dacut/hdmi-breakout/Out of stock.xlsx

JLCPCB Part # | Manufacturer | Manufacturer Part # | Description | Replacement | Replacement JLCPCB Part # | Replacement Manufacturer | Replacement Manufacturer Part # | Quote Ok?
C1856484 | Yageo | CC0402MRX6S5BB106 | 10uF 20% 0402 Cap | 10uF 20% 0805 Cap | C346216 | Samsung Electro-Mechanics | CL21A106MOFNNNE | N
C4231501 | KOA Speer Electric | SG73P1EWTTP2212F | 22.1k 1% 0402 Res | 22.1k 1% 0402 Res | C2130243 | Vishay Intertech | TNPW040222K1FEED | N
C4112064 | KOA Speer Electric | SG73P1EWTTP331G | 330 1% 0402 Res | 330 1% 0402 Res | C2131941 | Vishay Intertech | TNPW0402330RDEED | N
C4319604 | KOA Speer Electric | SG73P1EWTTP5101F | 5.1k 1% 0402 Res | 5.1k 1% 0402 Res | C2131849 | Vishay Intertech | TNPW04025K10DEED | ?
C4351795 | KOA Speer Electric | SG73P1EWTTP4751F | 4.75k 1% 0402 Res | 4.75k 1% 0402 Res | C4096848 | Vishay Intertech | TNPW04024K75DEED | N
C2500653 | KOA Speer Electric | RN73R1ETTP7061F25 | 7.06k 1% 0402 Res | 7.06k 1% 0402 Res | C4345381 | Vishay Intertech | TNPW04027K06DEED | N
C346216 | Samsung Electro-Mechanics | CL21A106MOFNNNE | 10uF 20% 0402 Cap | 10uF 20% 0805 Cap | C5189822 | Samwha Capacitor | CS2012X7R106M100NRE
C2130243 | Vishay Intertech | TNPW040222K1FEED | 22.1k 1% 0402 Res | 22.1k 1% 0402 Res | C43473 | Uni-Royal | 0402WGF2212TCE
C2131941 | Vishay Intertech | TNPW0402330RDEED | 330 1% 0402 Res | 330 1% 0402 Res | C427206 | Panasonic | ERJPA2J331X
C4096848 | Vishay Intertech | TNPW04024K75DEED | 4.75k 1% 0402 Res | 4.75k 1% 0402 Res | C25901 | Uni-Royal | 0402WGF4751TCE
~~C4345381~~ | ~~Vishay Intertech~~ | ~~TNPW04027K06DEED~~ | ~~7.06k 1% 0402 Res~~ | ~~7.06k 1% 0402 Res~~
