dacut/hdmi-breakout/HDMI Breakout.kicad_pcb

## KiCad design HDMI Breakout.kicad_pcb (2024-10-12)

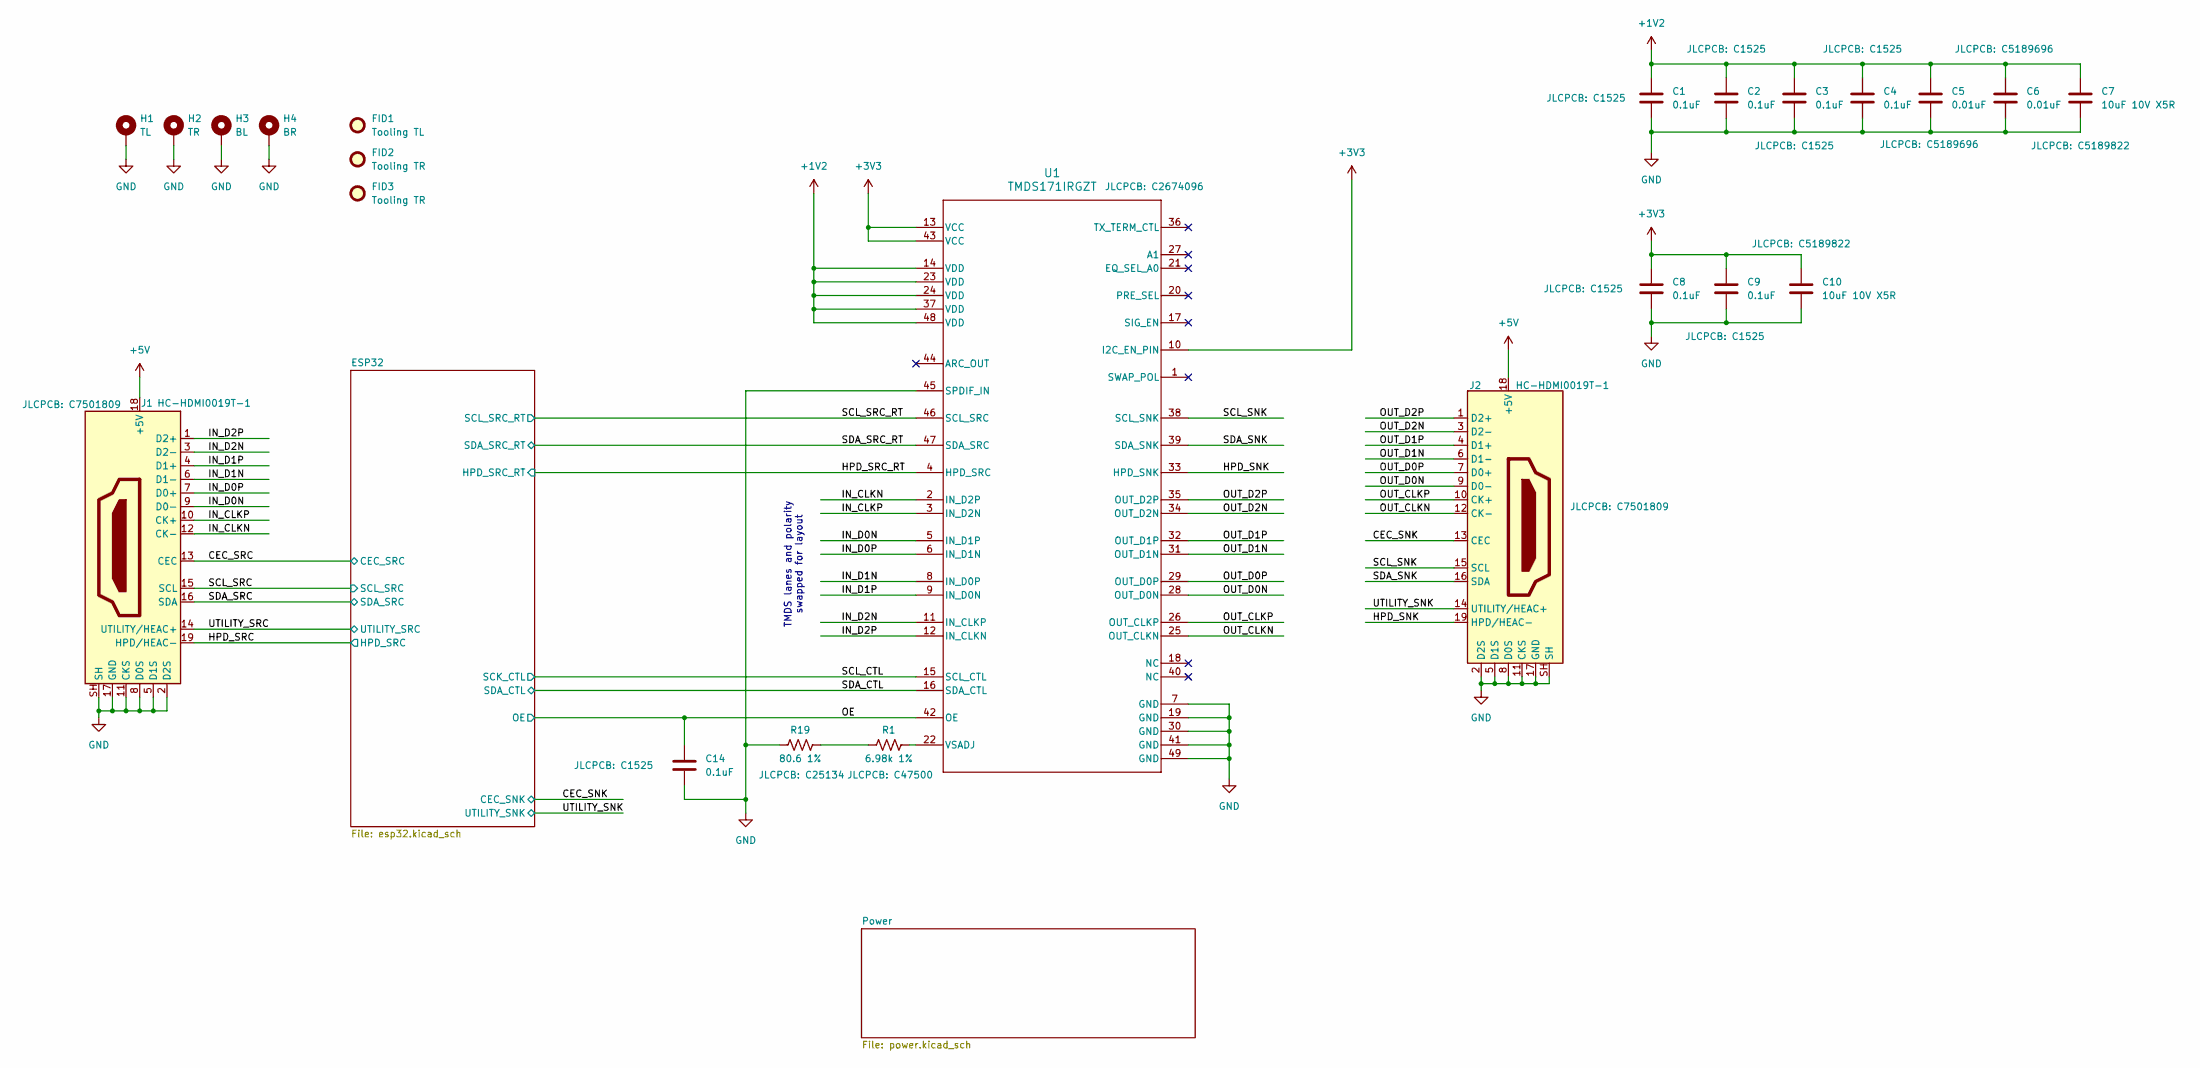
[picture p1: schematic HDMI Breakout.kicad_sch]

Parts:
C1, C2, C3, C4, C8, C9, C14: 0.1uF; C_0402_1005Metric; JLCPCB C1525
C5, C6: 0.01uF; C_0402_1005Metric; JLCPCB C5189696
C7, C10: 10uF 10V X5R; C_0805_2012Metric; JLCPCB C5189822
FID1: Tooling TL; Fiducial_JLCPCB
FID2, FID3: Tooling TR; Fiducial_JLCPCB
H1: TL; MountingHole_2.2mm_M2_Pad
H2: TR; MountingHole_2.2mm_M2_Pad
H3: BL; MountingHole_2.2mm_M2_Pad
H4: BR; MountingHole_2.2mm_M2_Pad
J1, J2: HC-HDMI0019T-1; JLCPCB C7501809
R1: 6.98k 1%; R_0402_1005Metric; JLCPCB C47500
R19: 80.6 1%; R_0402_1005Metric; JLCPCB C25134
U1: TMDS171IRGZT; RGZ0048B_NV; JLCPCB C2674096

Connections:
+1V2: C1.1, C2.1, C3.1, C4.1, C5.1, C6.1, C7.1, U1.14 (VDD), U1.23 (VDD), U1.24 (VDD), U1.37 (VDD), U1.48 (VDD); also elsewhere on the board
+3V3: C8.1, C9.1, C10.1, U1.10 (I2C_EN_PIN), U1.13 (VCC), U1.43 (VCC); also elsewhere on the board
+5V: J1.18 (+5V), J2.18 (+5V); also elsewhere on the board
/CEC_SNK: J2.13 (CEC); also elsewhere on the board
/CEC_SRC: J1.13 (CEC); also elsewhere on the board
/HPD_SNK: J2.19 (HPD/HEAC-), U1.33 (HPD_SNK)
/HPD_SRC: J1.19 (HPD/HEAC-); also elsewhere on the board
/HPD_SRC_RT: U1.4 (HPD_SRC); also elsewhere on the board
/IN_CLKN: J1.12 (CK-), U1.2 (IN_D2P)
/IN_CLKP: J1.10 (CK+), U1.3 (IN_D2N)
/IN_D0N: J1.9 (D0-), U1.5 (IN_D1P)
/IN_D0P: J1.7 (D0+), U1.6 (IN_D1N)
/IN_D1N: J1.6 (D1-), U1.8 (IN_D0P)
/IN_D1P: J1.4 (D1+), U1.9 (IN_D0N)
/IN_D2N: J1.3 (D2-), U1.11 (IN_CLKP)
/IN_D2P: J1.1 (D2+), U1.12 (IN_CLKN)
/OE: C14.1, U1.42 (OE); also elsewhere on the board
/OUT_CLKN: J2.12 (CK-), U1.25 (OUT_CLKN)
/OUT_CLKP: J2.10 (CK+), U1.26 (OUT_CLKP)
/OUT_D0N: J2.9 (D0-), U1.28 (OUT_D0N)
/OUT_D0P: J2.7 (D0+), U1.29 (OUT_D0P)
/OUT_D1N: J2.6 (D1-), U1.31 (OUT_D1N)
/OUT_D1P: J2.4 (D1+), U1.32 (OUT_D1P)
/OUT_D2N: J2.3 (D2-), U1.34 (OUT_D2N)
/OUT_D2P: J2.1 (D2+), U1.35 (OUT_D2P)
/SCL_CTL: U1.15 (SCL_CTL); also elsewhere on the board
/SCL_SNK: J2.15 (SCL), U1.38 (SCL_SNK)
/SCL_SRC: J1.15 (SCL); also elsewhere on the board
/SCL_SRC_RT: U1.46 (SCL_SRC); also elsewhere on the board
/SDA_CTL: U1.16 (SDA_CTL); also elsewhere on the board
/SDA_SNK: J2.16 (SDA), U1.39 (SDA_SNK)
/SDA_SRC: J1.16 (SDA); also elsewhere on the board
/SDA_SRC_RT: U1.47 (SDA_SRC); also elsewhere on the board
/UTILITY_SNK: J2.14 (UTILITY/HEAC+); also elsewhere on the board
/UTILITY_SRC: J1.14 (UTILITY/HEAC+); also elsewhere on the board
GND: C1.2, C2.2, C3.2, C4.2, C5.2, C6.2, C7.2, C8.2, C9.2, C10.2, C14.2, H1.1, H2.1, H3.1, H4.1, J1.2 (D2S), J1.5 (D1S), J1.8 (D0S), J1.11 (CKS), J1.17 (GND), J1.SH, J2.2 (D2S), J2.5 (D1S), J2.8 (D0S), J2.11 (CKS), J2.17 (GND), J2.SH, R19.1, U1.7 (GND), U1.19 (GND), U1.30 (GND), U1.41 (GND), U1.45 (SPDIF_IN), U1.49 (GND); also elsewhere on the board
unnamed: R1.1, R19.2
unnamed: R1.2, U1.22 (VSADJ)

Notes on the sheet:
TMDS lanes and polarity swapped for layout

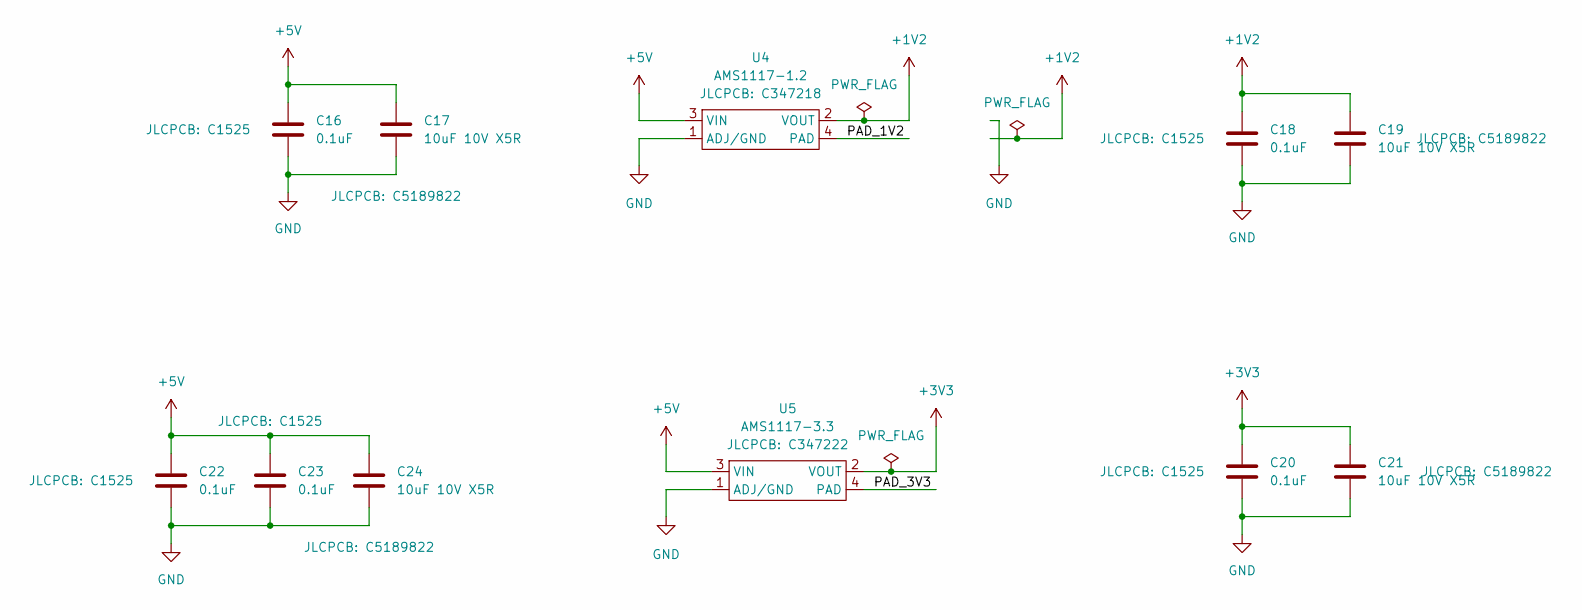
[picture p2: schematic power.kicad_sch]

Parts:
C16, C18, C20, C22, C23: 0.1uF; C_0402_1005Metric; JLCPCB C1525
C17, C19, C21, C24: 10uF 10V X5R; C_0805_2012Metric; JLCPCB C5189822
U4: AMS1117-1.2; SOT-223; JLCPCB C347218
U5: AMS1117-3.3; SOT-223; JLCPCB C347222

Connections:
+1V2: C18.1, C19.1, U4.2 (VOUT); also elsewhere on the board
+3V3: C20.1, C21.1, U5.2 (VOUT); also elsewhere on the board
+5V: C16.1, C17.1, C22.1, C23.1, C24.1, U4.3 (VIN), U5.3 (VIN); also elsewhere on the board
/Power/PAD_1V2: U4.4 (PAD)
/Power/PAD_3V3: U5.4 (PAD)
GND: C16.2, C17.2, C18.2, C19.2, C20.2, C21.2, C22.2, C23.2, C24.2, U4.1 (ADJ/GND), U5.1 (ADJ/GND); also elsewhere on the board

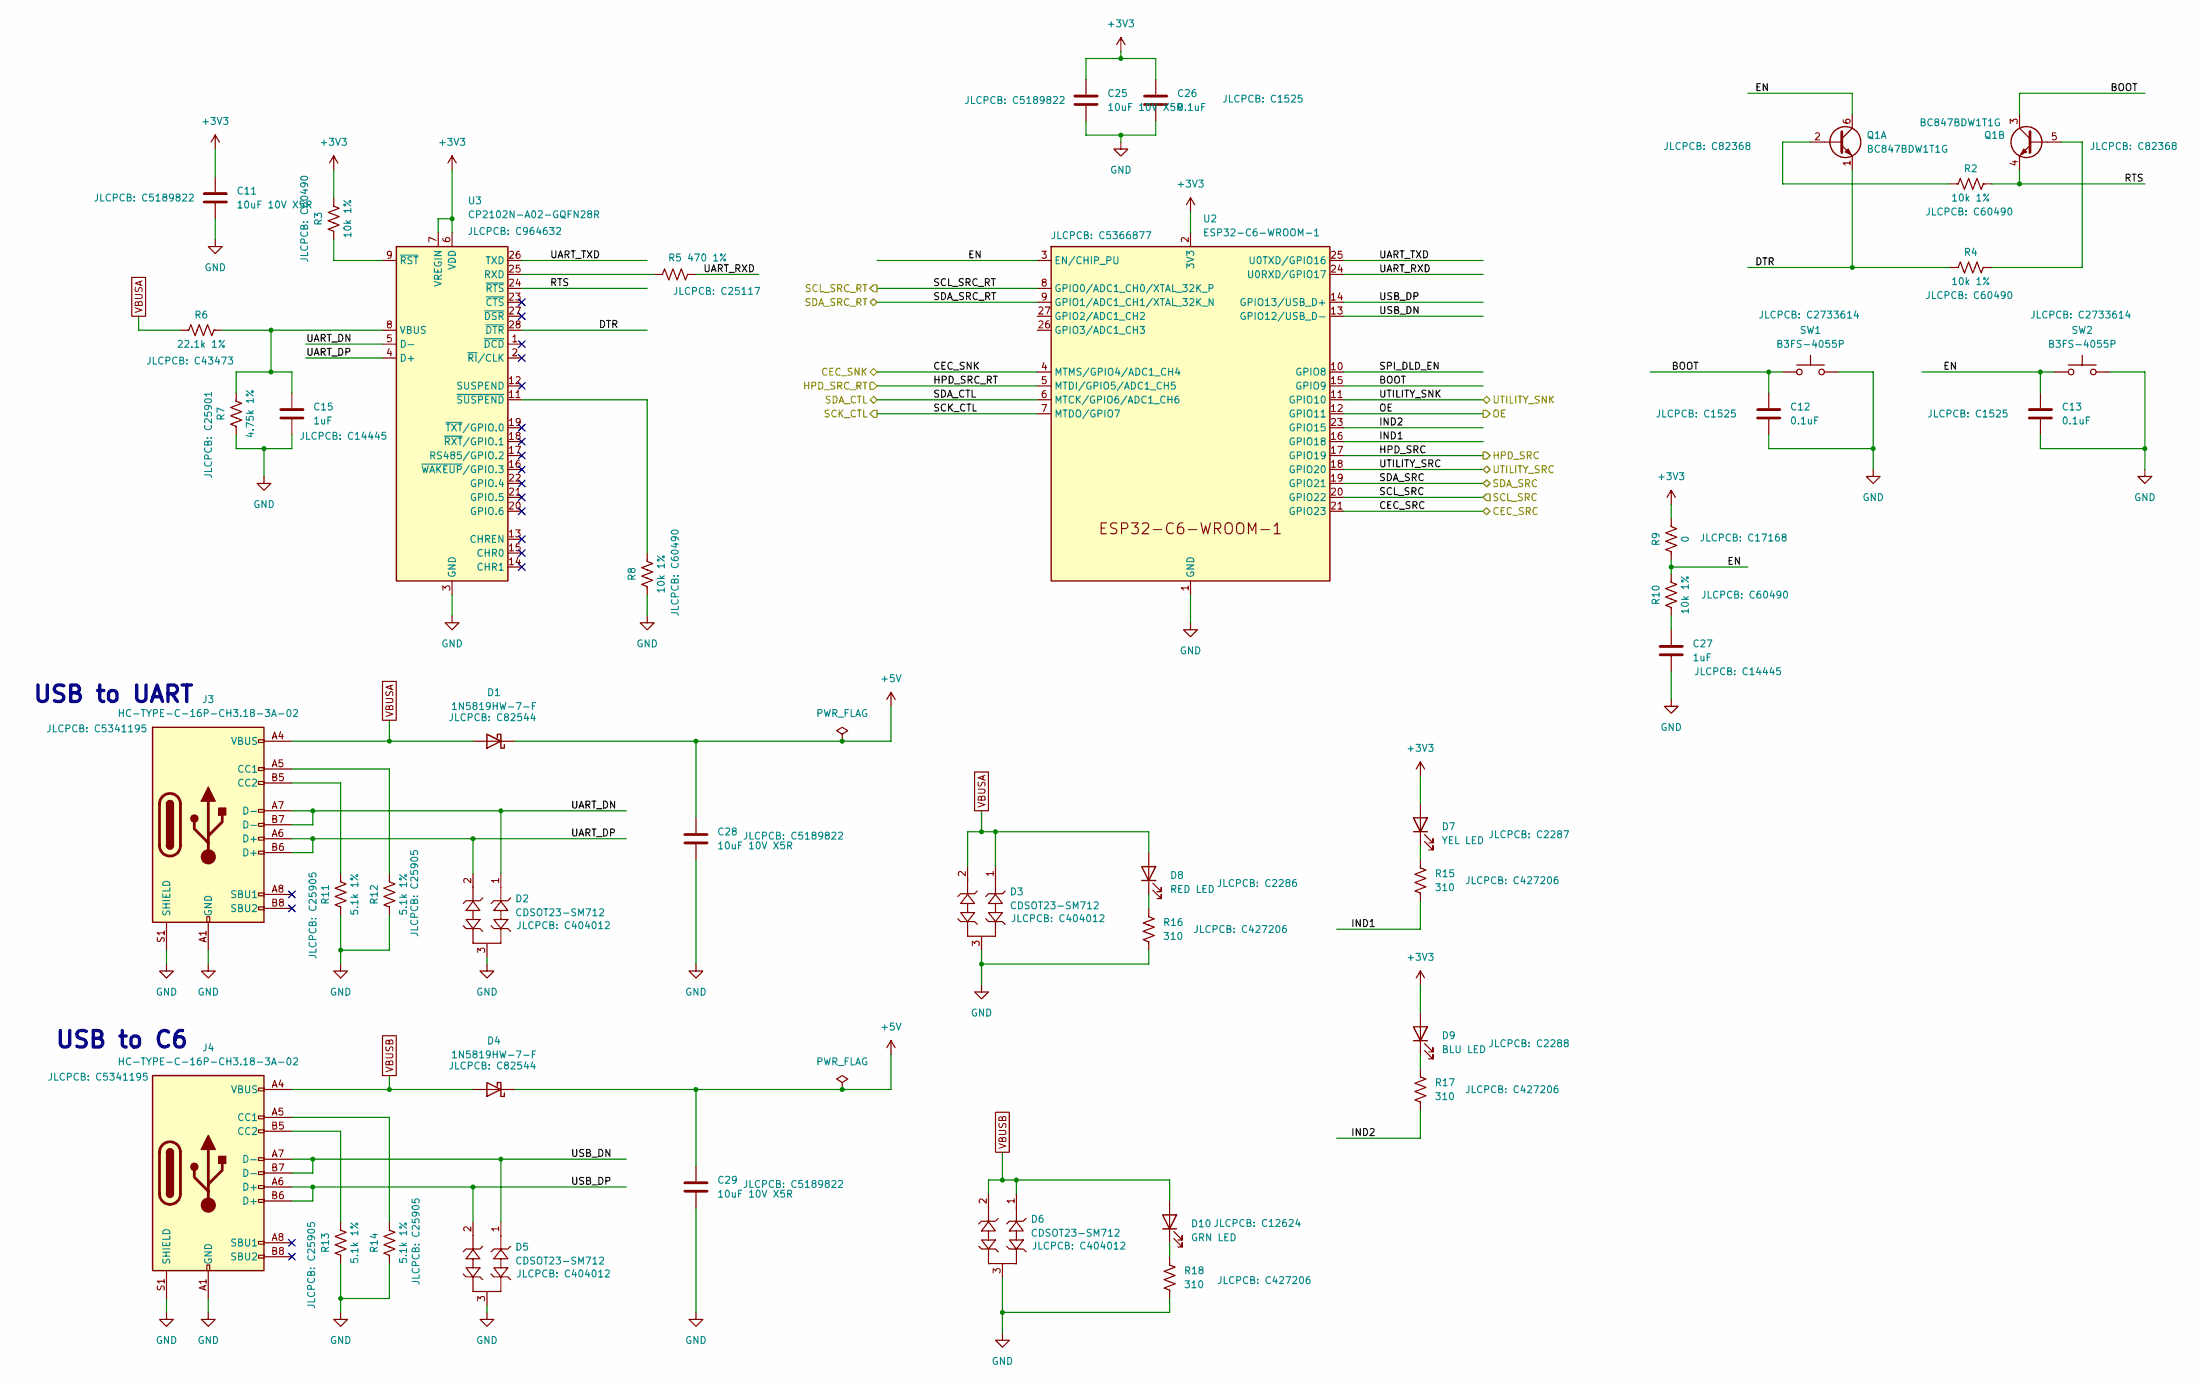
[picture p3: schematic esp32.kicad_sch]

Parts:
C11, C25, C28, C29: 10uF 10V X5R; C_0805_2012Metric; JLCPCB C5189822
C12, C13, C26: 0.1uF; C_0402_1005Metric; JLCPCB C1525
C15, C27: 1uF; C_0402_1005Metric; JLCPCB C14445
D1, D4: 1N5819HW-7-F; D_SOD-123; JLCPCB C82544
D2, D3, D5, D6: CDSOT23-SM712; SOT-23; JLCPCB C404012
D7: YEL LED; LED_0603_1608Metric; JLCPCB C2287
D8: RED LED; LED_0603_1608Metric; JLCPCB C2286
D9: BLU LED; LED_0603_1608Metric; JLCPCB C2288
D10: GRN LED; LED_0603_1608Metric; JLCPCB C12624
J3, J4: HC-TYPE-C-16P-CH3.18-3A-02; USB_C_Receptacle_HCTL_HC-TYPE-C-16P-01A; JLCPCB C5341195
Q1: BC847BDW1T1G; SOT-363_SC-70-6; JLCPCB C82368
R2, R3, R4, R8, R10: 10k 1%; R_0402_1005Metric; JLCPCB C60490
R5: 470 1%; R_0402_1005Metric; JLCPCB C25117
R6: 22.1k 1%; R_0402_1005Metric; JLCPCB C43473
R7: 4.75k 1%; R_0402_1005Metric; JLCPCB C25901
R9: 0; R_0402_1005Metric; JLCPCB C17168
R11, R12, R13, R14: 5.1k 1%; R_0402_1005Metric; JLCPCB C25905
R15, R16, R17, R18: 310; R_0402_1005Metric; JLCPCB C427206
SW1, SW2: B3FS-4055P; SW_SPST_Omron_B3FS-4000; JLCPCB C2733614
U2: ESP32-C6-WROOM-1; JLCPCB C5366877
U3: CP2102N-A02-GQFN28R; QFN-28-1EP_5x5mm_P0.5mm_EP3.35x3.35mm; JLCPCB C964632

Connections:
+3V3: C11.1, C25.1, C26.1, D7.2 (A), D9.2 (A), R3.2, R9.2, U2.2 (3V3), U3.6 (VDD), U3.7 (VREGIN); also elsewhere on the board
+5V: C28.1, C29.1, D1.1 (K), D4.1 (K); also elsewhere on the board
/CEC_SNK: U2.4 (MTMS/GPIO4/ADC1_CH4); also elsewhere on the board
/CEC_SRC: U2.21 (GPIO23); also elsewhere on the board
/ESP32/BOOT: C12.1, Q1.3 (C2), SW1.1, U2.15 (GPIO9)
/ESP32/DTR: Q1.1 (E1), R4.1, U3.28 (~DTR)
/ESP32/EN: C13.1, Q1.6 (C1), R9.1, R10.2, SW2.1, U2.3 (EN/CHIP_PU)
/ESP32/IND1: R15.2, U2.16 (GPIO18)
/ESP32/IND2: R17.2, U2.23 (GPIO15)
/ESP32/RTS: Q1.4 (E2), R2.2, U3.24 (~RTS)
/ESP32/SPI_DLD_EN: U2.10 (GPIO8)
/ESP32/UART_DN: D2.1, J3.A7 (D-), J3.B7 (D-), U3.5 (D-)
/ESP32/UART_DP: D2.2, J3.A6 (D+), J3.B6 (D+), U3.4 (D+)
/ESP32/UART_RXD: R5.2, U2.24 (U0RXD/GPIO17)
/ESP32/UART_TXD: U2.25 (U0TXD/GPIO16), U3.26 (TXD)
/ESP32/USB_DN: D5.1, J4.A7 (D-), J4.B7 (D-), U2.13 (GPIO12/USB_D-)
/ESP32/USB_DP: D5.2, J4.A6 (D+), J4.B6 (D+), U2.14 (GPIO13/USB_D+)
/HPD_SRC: U2.17 (GPIO19); also elsewhere on the board
/HPD_SRC_RT: U2.5 (MTDI/GPIO5/ADC1_CH5); also elsewhere on the board
/OE: U2.12 (GPIO11); also elsewhere on the board
/SCL_CTL: U2.7 (MTDO/GPIO7); also elsewhere on the board
/SCL_SRC: U2.20 (GPIO22); also elsewhere on the board
/SCL_SRC_RT: U2.8 (GPIO0/ADC1_CH0/XTAL_32K_P); also elsewhere on the board
/SDA_CTL: U2.6 (MTCK/GPIO6/ADC1_CH6); also elsewhere on the board
/SDA_SRC: U2.19 (GPIO21); also elsewhere on the board
/SDA_SRC_RT: U2.9 (GPIO1/ADC1_CH1/XTAL_32K_N); also elsewhere on the board
/UTILITY_SNK: U2.11 (GPIO10); also elsewhere on the board
/UTILITY_SRC: U2.18 (GPIO20); also elsewhere on the board
GND: C11.2, C12.2, C13.2, C15.2, C25.2, C26.2, C27.2, C28.2, C29.2, D2.3, D3.3, D5.3, D6.3, J3.A1 (GND), J3.A12 (GND), J3.B1 (GND), J3.B12 (GND), J3.S1 (SHIELD), J4.A1 (GND), J4.A12 (GND), J4.B1 (GND), J4.B12 (GND), J4.S1 (SHIELD), R7.1, R8.1, R11.1, R12.1, R13.1, R14.1, R16.2, R18.2, SW1.2, SW2.2, U2.1 (GND), U2.28 (GND), U2.29 (GND), U3.3 (GND), U3.29 (GND); also elsewhere on the board
unnamed: C27.1, R10.1
unnamed: D7.1 (K), R15.1
unnamed: D8.1 (K), R16.1
unnamed: D9.1 (K), R17.1
unnamed: D10.1 (K), R18.1
unnamed: J3.A5 (CC1), R12.2
unnamed: J3.B5 (CC2), R11.2
unnamed: J4.A5 (CC1), R14.2
unnamed: J4.B5 (CC2), R13.2
unnamed: Q1.2 (B1), R2.1
unnamed: Q1.5 (B2), R4.2
unnamed: R5.1, U3.25 (RXD)
unnamed: C15.1, R6.2, R7.2, U3.8 (VBUS)
unnamed: R3.1, U3.9 (~RST)
unnamed: R8.2, U3.11 (~SUSPEND)
VBUSA: D1.2 (A), D3.1, D3.2, D8.2 (A), J3.A4 (VBUS), J3.A9 (VBUS), J3.B4 (VBUS), J3.B9 (VBUS), R6.1
VBUSB: D4.2 (A), D6.1, D6.2, D10.2 (A), J4.A4 (VBUS), J4.A9 (VBUS), J4.B4 (VBUS), J4.B9 (VBUS)

Notes on the sheet:
USB to C6
USB to UART

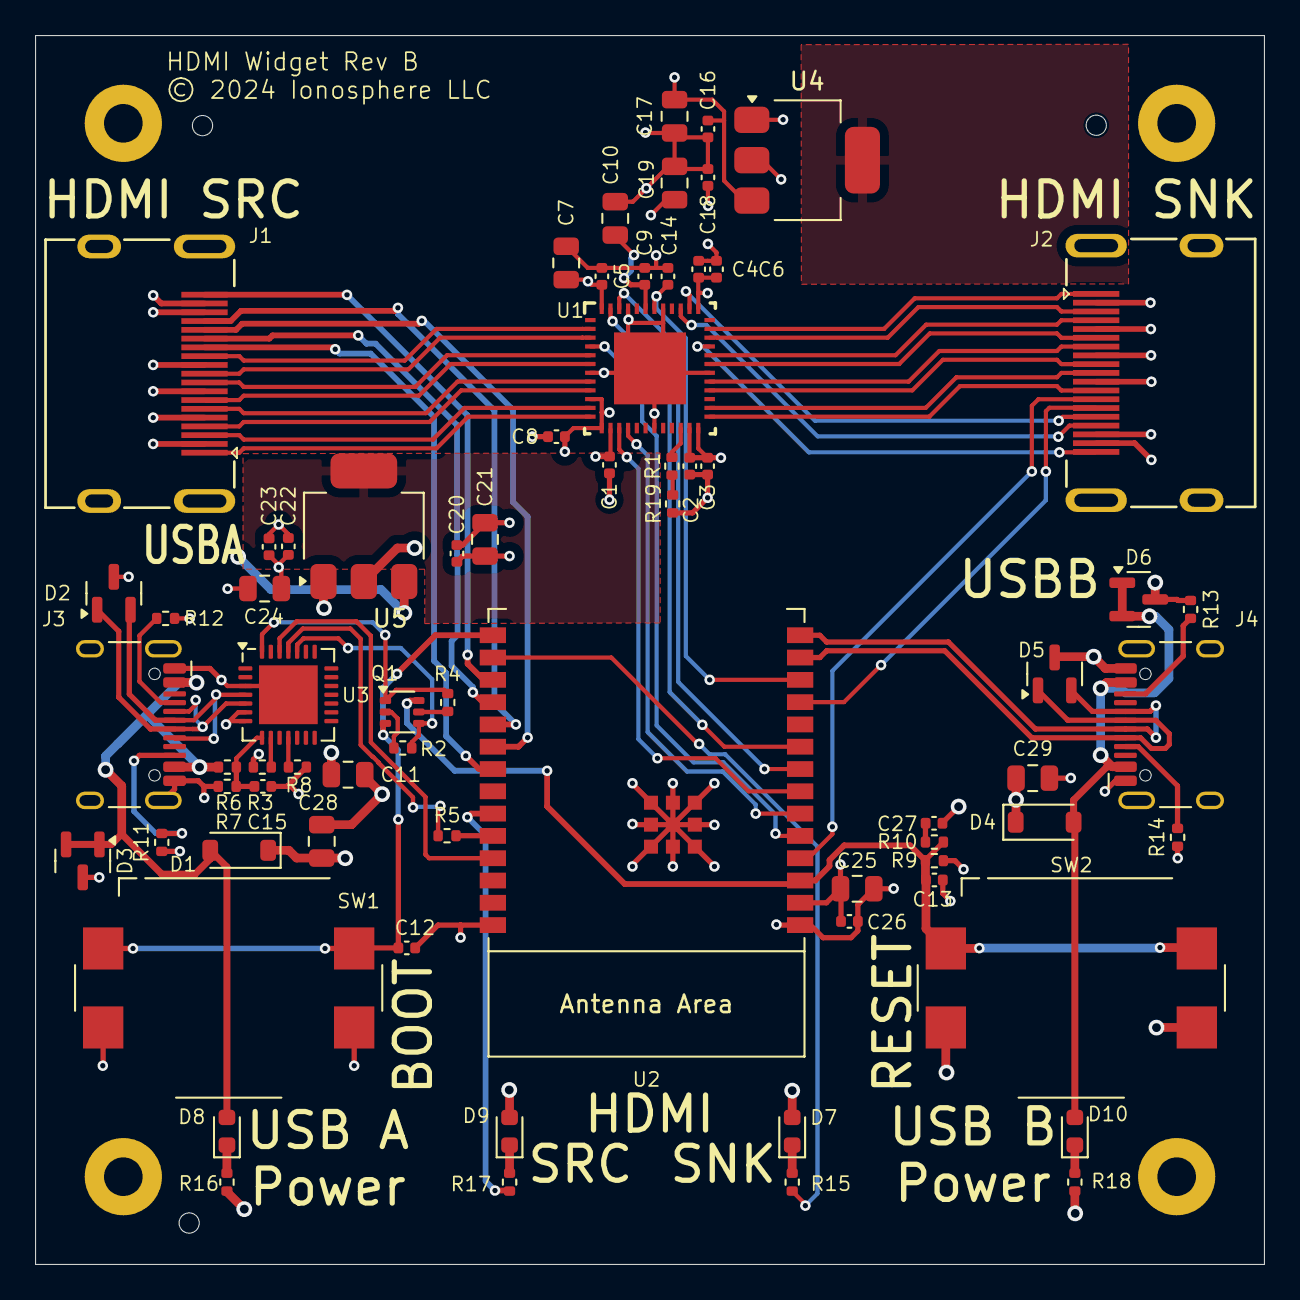
[picture p4: board HDMI Breakout.kicad_pcb from above]

Board: 4 copper layers, 70.0 x 70.0 mm, 77 parts (0 on the bottom side), 67 nets.
