dacut/hdmi-breakout/(commit log)

2024-09-03 Checkpoint before modifying JLCPCB part numbers.
    [HDMI Breakout BOM.csv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]
2024-09-06 Before fixup2
    [HDMI Breakout BOM.csv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]
2024-09-21 Update before DFM changes
    [HDMI Breakout BOM 2024-09-20 r1.xlsx, HDMI Breakout BOM.csv, HDMI Breakout BOM.xlsx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]
2024-10-12 Remove(-ish) backup ZIP files
    Yeah, I know this won't be deleted from the Git history, but at least
    it de-pollutes the working directory.
2024-10-12 Checkpointing before moving to 1206 components
    [HDMI Breakout-B_Cu.gbl, HDMI Breakout-B_Mask.gbs, HDMI Breakout-B_Paste.gbp, HDMI Breakout-B_Silkscreen.gbo, HDMI Breakout-Edge_Cuts.gm1, HDMI Breakout-F_Cu.gtl, HDMI Breakout-F_Mask.gts, HDMI Breakout-F_Paste.gtp]
