dacut/hdmi-breakout/(notices)

Notices in the files:
HDMI Breakout.kicad_pcb:
© 2024 Ionosphere LLC
